bjoumier/2025_PSE_B6_gsailly_bjoumier/Materiel/Xx_montre_connectee_pse_xX/regulateur/LTC3531ES6-3.3.step

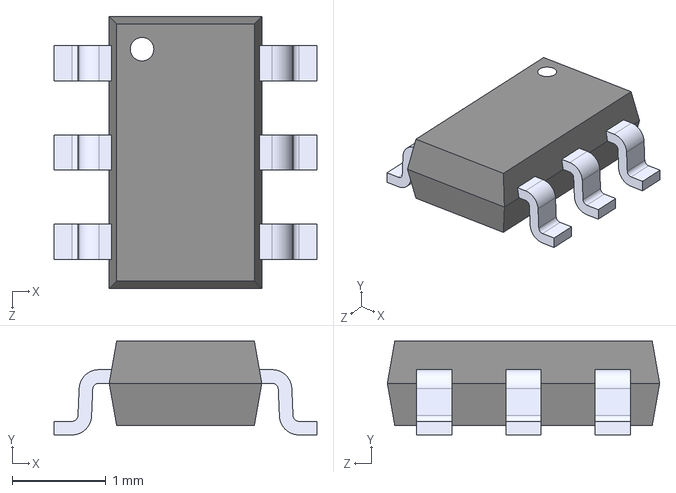
[picture p6: CAD file, 2026-09-30]
Materiel/Xx_montre_connectee_pse_xX/regulateur/LTC3531ES6-3.3.step
2.80 x 1.00 x 2.90 mm
