bjoumier/2025_PSE_B6_gsailly_bjoumier/Materiel/Xx_montre_connectee_pse_xX/inductance_buck_boost/B82462G4103M000.step

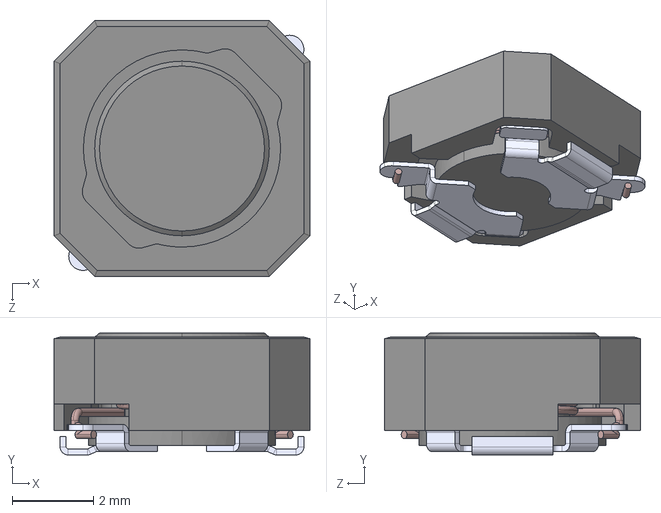
[picture p7: CAD file, 2026-09-30]
Materiel/Xx_montre_connectee_pse_xX/inductance_buck_boost/B82462G4103M000.step
6.30 x 3.00 x 6.30 mm
