bjoumier/2025_PSE_B6_gsailly_bjoumier/Materiel/Xx_montre_connectee_pse_xX/Xx_montre_connectee_pse_xX.kicad_pcb

## KiCad design Materiel/Xx_montre_connectee_pse_xX/Xx_montre_connectee_pse_xX.kicad_pcb (2026-09-30)

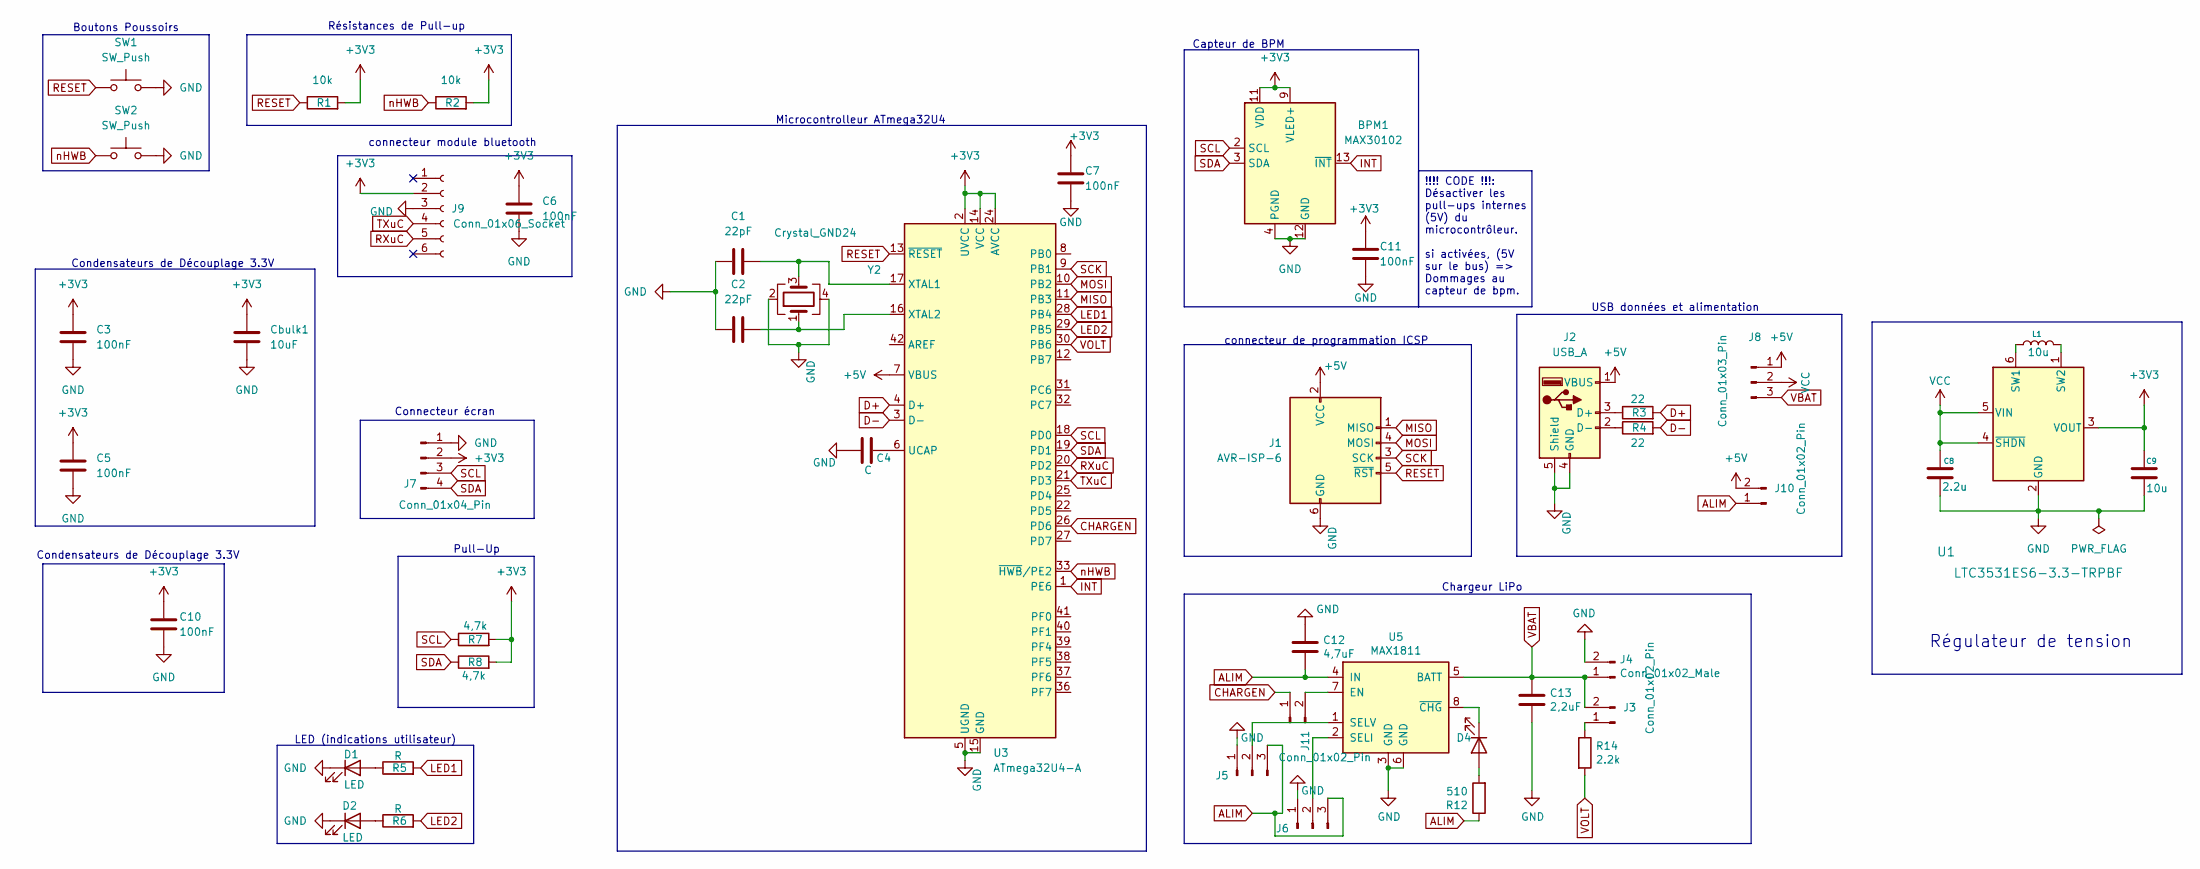
[picture p8: schematic Xx_montre_connectee_pse_xX.kicad_sch]

Parts:
BPM1: MAX30102; Maxim_OLGA-14_3.3x5.6mm_P0.8mm
C1, C2: 22pF; C_0603_1608Metric_Pad1.08x0.95mm_HandSolder
C3, C5, C6, C7, C10, C11: 100nF; C_0603_1608Metric_Pad1.08x0.95mm_HandSolder
C4: C; C_0603_1608Metric_Pad1.08x0.95mm_HandSolder
C8: 2.2u; C_0603_1608Metric_Pad1.08x0.95mm_HandSolder
C9: 10u; C_0603_1608Metric_Pad1.08x0.95mm_HandSolder
C12: 4,7uF; C_0603_1608Metric_Pad1.08x0.95mm_HandSolder
C13: 2,2uF; C_0603_1608Metric_Pad1.08x0.95mm_HandSolder
Cbulk1: 10uF; C_0603_1608Metric_Pad1.08x0.95mm_HandSolder
D1, D2, D4: LED; LED_0603_1608Metric_Pad1.05x0.95mm_HandSolder
J1: AVR-ISP-6; PinHeader_2x03_P2.54mm_Vertical
J2: USB_A; USB_A_CNCTech_1001-011-01101_Horizontal
J3, J10, J11: Conn_01x02_Pin; PinHeader_1x02_P2.54mm_Vertical
J4: Conn_01x02_Male; Molex_PicoBlade_53047-0210_1x02_P1.25mm_Vertical
J5, J6: Conn_01x03_Male; PinHeader_1x03_P2.54mm_Vertical
J7: Conn_01x04_Pin; PinHeader_1x04_P2.54mm_Vertical
J8: Conn_01x03_Pin; PinHeader_1x03_P2.54mm_Vertical
J9: Conn_01x06_Socket; PinHeader_1x06_P2.54mm_Vertical
L1: 10u; IND_EPCOS_B82462G4_EPC
R1, R2: 10k; R_0603_1608Metric_Pad0.98x0.95mm_HandSolder
R3, R4: 22; R_0603_1608Metric_Pad0.98x0.95mm_HandSolder
R5, R6: R; R_0603_1608Metric_Pad0.98x0.95mm_HandSolder
R7, R8: 4,7k; R_0603_1608Metric_Pad0.98x0.95mm_HandSolder
R12: 510; R_0603_1608Metric_Pad0.98x0.95mm_HandSolder
R14: 2.2k; R_0603_1608Metric_Pad0.98x0.95mm_HandSolder
SW1, SW2: SW_Push; SW_SPST_TL3342
U1: LTC3531ES6-3.3-TRPBF; TSOT-23_S6_LIT
U3: ATmega32U4-A; TQFP-44_10x10mm_P0.8mm
U5: MAX1811; SOIC-8_3.9x4.9mm_P1.27mm
Y2: Crystal_GND24; Crystal_SMD_0603-4Pin_6.0x3.5mm_HandSoldering

Connections:
+3V3: BPM1.9 (VLED+), BPM1.10 (VLED+), BPM1.11 (VDD), C3.1, C5.1, C6.1, C7.1, C9.2, C10.1, C11.1, Cbulk1.1, J7.2, J9.2, R1.2, R2.2, R7.2, R8.2, U1.3 (VOUT), U3.2 (UVCC), U3.14 (VCC), U3.24 (AVCC), U3.34 (VCC), U3.44 (AVCC)
+5V: J1.2 (VCC), J2.1 (VBUS), J8.1, J10.2, U3.7 (VBUS)
ALIM: C12.2, J5.3, J6.3, J10.1, R12.1, U5.4 (IN)
CHARGEN: J11.1, U3.26 (PD6)
D+: R3.2, U3.4 (D+)
D-: R4.2, U3.3 (D-)
GND: BPM1.4 (PGND), BPM1.12 (GND), C1.1, C2.1, C3.2, C4.2, C5.2, C6.2, C7.2, C8.1, C9.1, C10.2, C11.2, C12.1, C13.2, Cbulk1.2, D1.1 (K), D2.1 (K), J1.6 (GND), J2.4 (GND), J2.5 (Shield), J4.2, J5.1, J6.1, J7.1, J9.3, SW1.2, SW2.2, U1.2 (GND), U3.5 (UGND), U3.15 (GND), U3.23 (GND), U3.35 (GND), U3.43 (GND), U5.3 (GND), U5.6 (GND), Y2.2, Y2.4
INT: BPM1.13 (~INT), U3.1 (PE6)
LED1: R5.2, U3.28 (PB4)
LED2: R6.2, U3.29 (PB5)
MISO: J1.1 (MISO), U3.11 (PB3)
MOSI: J1.4 (MOSI), U3.10 (PB2)
unnamed: D1.2 (A), R5.1
unnamed: D2.2 (A), R6.1
unnamed: D4.2 (A), R12.2
unnamed: D4.1 (K), U5.8 (~CHG)
unnamed: J2.3 (D+), R3.1
unnamed: J2.2 (D-), R4.1
unnamed: J3.1, R14.1
unnamed: J5.2, U5.1 (SELV)
unnamed: J6.2, U5.2 (SELI)
unnamed: J11.2, U5.7 (EN)
unnamed: L1.1, U1.6 (SW1)
unnamed: L1.2, U1.1 (SW2)
unnamed: C4.1, U3.6 (UCAP)
unnamed: C1.2, U3.17 (XTAL1), Y2.3
unnamed: C2.2, U3.16 (XTAL2), Y2.1
RESET: J1.5 (~RST), R1.1, SW1.1, U3.13 (~RESET)
RXuC: J9.5, U3.20 (PD2)
SCK: J1.3 (SCK), U3.9 (PB1)
SCL: BPM1.2 (SCL), J7.3, R7.1, U3.18 (PD0)
SDA: BPM1.3 (SDA), J7.4, R8.1, U3.19 (PD1)
TXuC: J9.4, U3.21 (PD3)
VBAT: C13.1, J3.2, J4.1, J8.3, U5.5 (BATT)
VCC: C8.2, J8.2, U1.4 (~SHDN), U1.5 (VIN)
VOLT: R14.2, U3.30 (PB6)
nHWB: R2.1, SW2.1, U3.33 (~HWB/PE2)

Notes on the sheet:
Chargeur LiPo
Pull-Up
connecteur module bluetooth
Connecteur écran
connecteur de programmation ICSP
Condensateurs de Découplage 3.3V
Résistances de Pull-up
Boutons Poussoirs
Capteur de BPM
Régulateur de tension
USB données et alimentation
LED (indications utilisateur)
Microcontrolleur ATmega32U4
!!!! CODE !!!: Désactiver les pull-ups internes (5V) du microcontrôleur. si activées, (5V sur le bus) => Dommages au capteur de bpm.

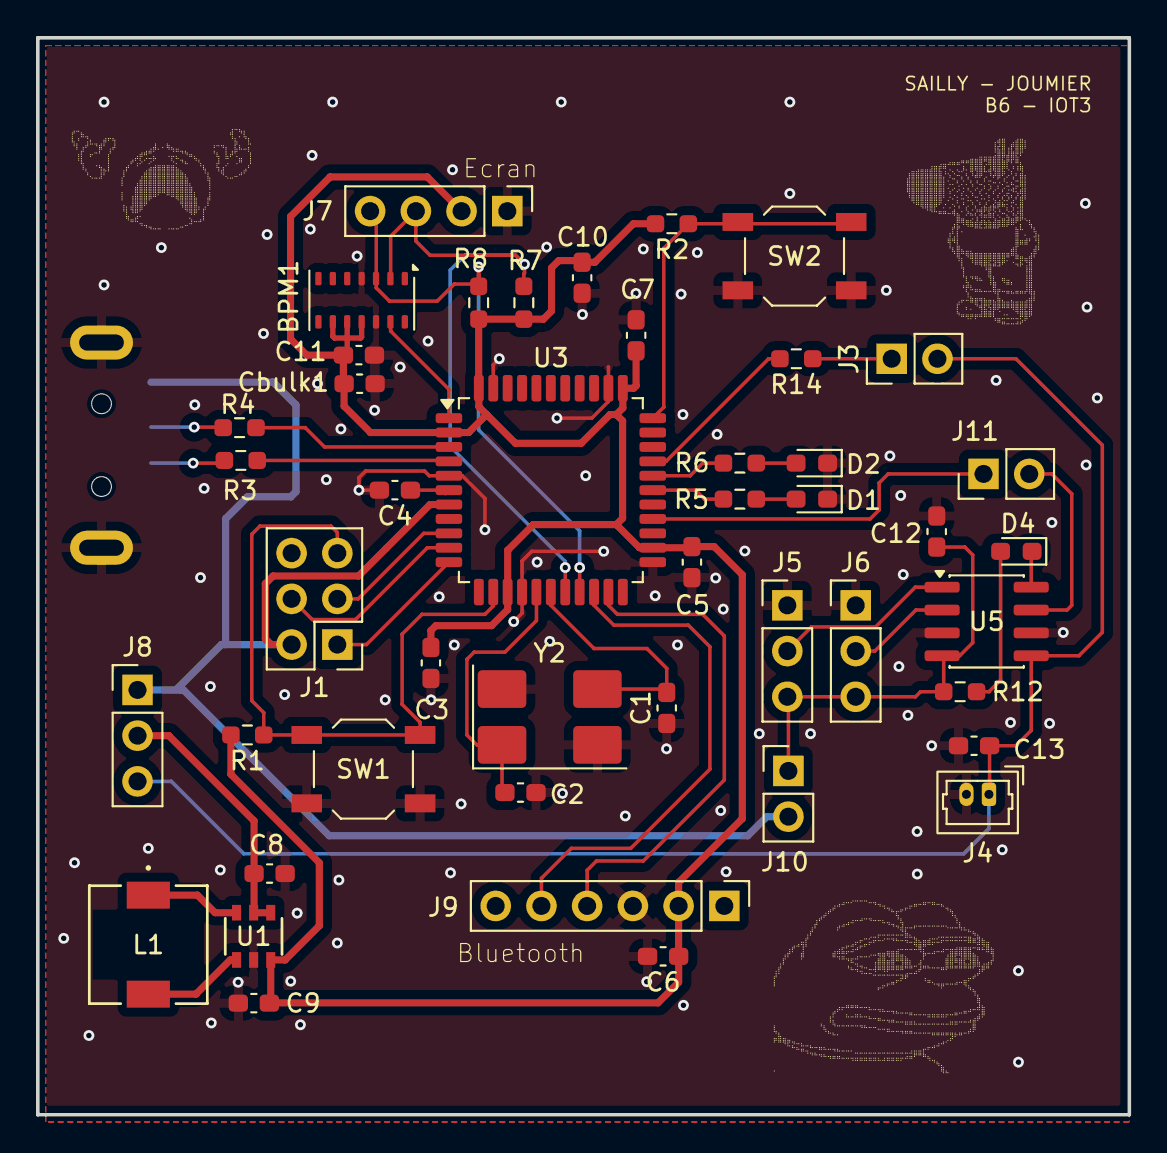
[picture p9: board Xx_montre_connectee_pse_xX.kicad_pcb from above]

Board: 2 copper layers, 60.6 x 59.8 mm, 46 parts (1 on the bottom side), 37 nets.
