bjoumier/2025_PSE_B6_gsailly_bjoumier/Logiciel/montre_connectee/src/i2c.h

#ifndef I2C_H
#define I2C_H

#include <stdint.h>

void i2c_init(void);

void i2c_start(uint8_t address);

void i2c_write(uint8_t data);

void i2c_stop(void);

uint8_t i2c_read_ack(void);

uint8_t i2c_read_nack(void);

#endif
